xdylanm/modular-system-psu/README.md

# Modular System PSU

A PSU for a modular Eurorack system, featuring +/-12V and 5V rails, USB-C input, and a regulated USB-A output.
