xdylanm/modular-system-psu/docs/assets/images/DCDC_filtering.png

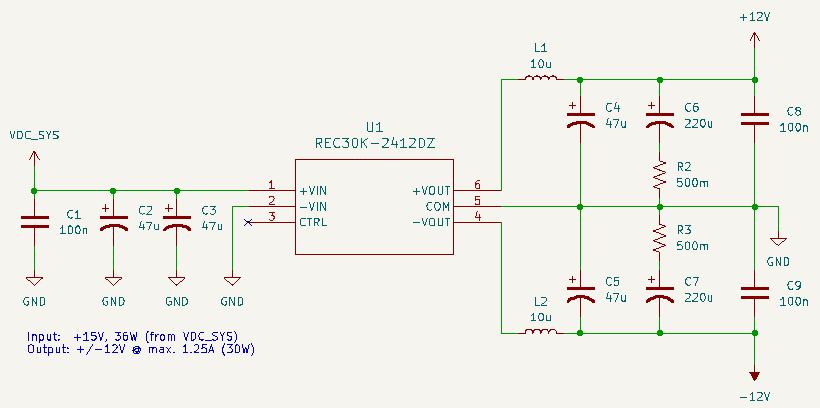
docs/assets/images/DCDC_filtering.png
