xdylanm/modular-system-psu/docs/assets/images/probe_5V_rail.jpg

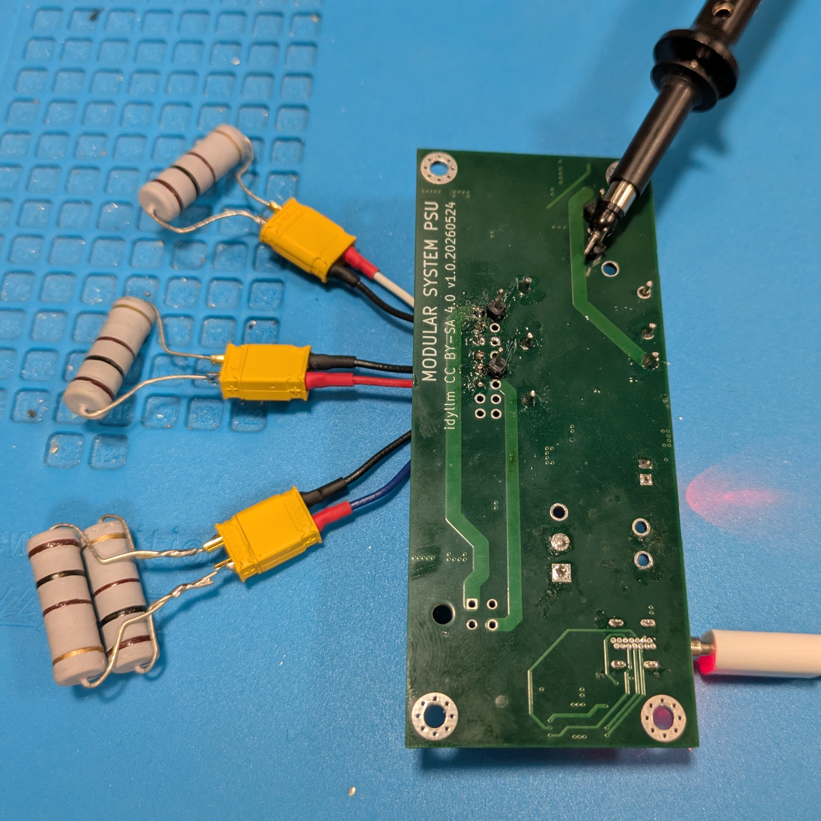
docs/assets/images/probe_5V_rail.jpg
