xdylanm/modular-system-psu/docs/assets/images/probe_recom_output_anno.jpg

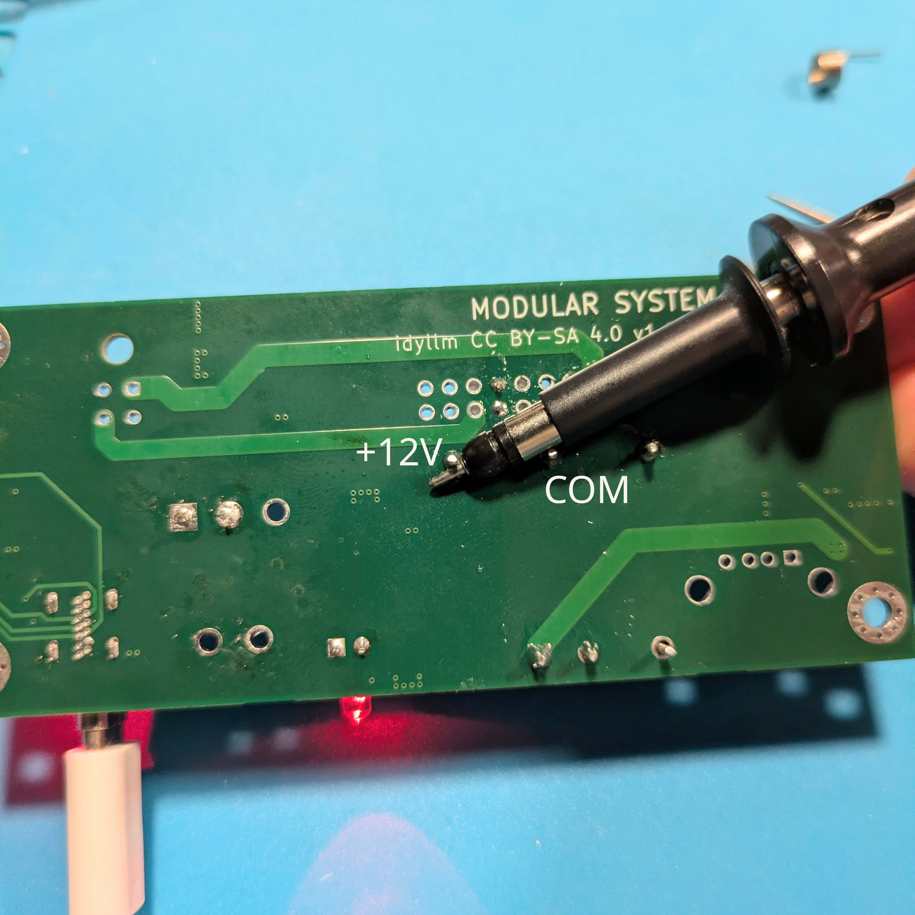
docs/assets/images/probe_recom_output_anno.jpg
