xdylanm/modular-system-psu/docs/assets/schematic.pdf

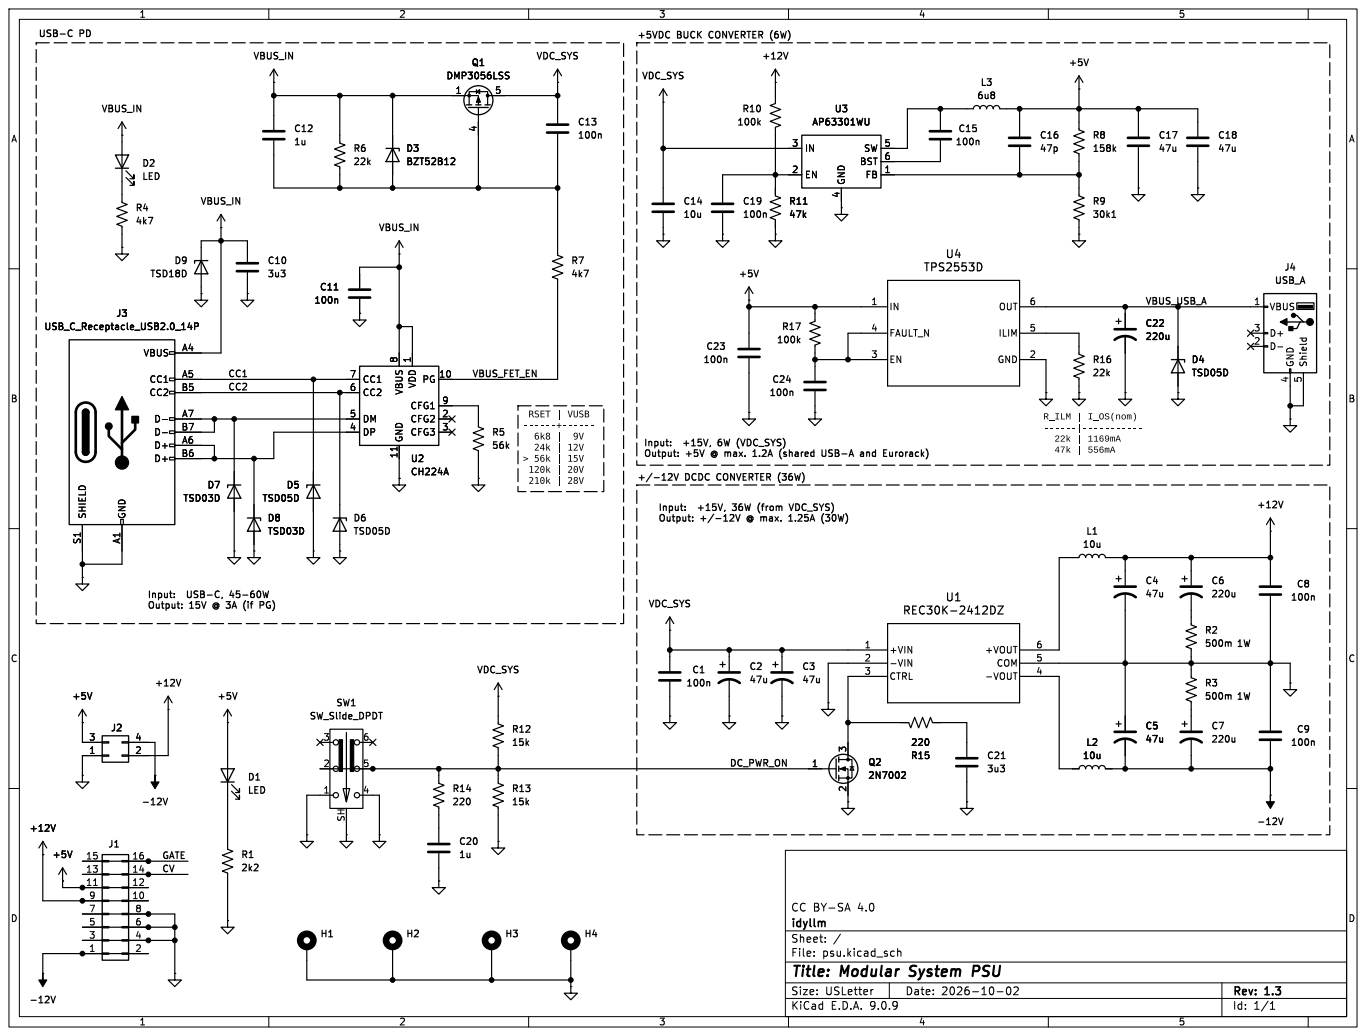
[picture p18: page 1]

1 PG 10 CFG1 9 CFG2 2 CFG3 3 U2 CH224A SHIELD S1 GND A1 VBUS A4 CC1 A5 CC2 B5 D- A7 D- B7 D+ A6 D+ B6

idyllm
File: psu.kicad_sch Sheet: /
Id: 1/1 Title: Modular System PSU
