xdylanm/modular-system-psu/docs/assets/archive/layout/Bottom-Layer-USBC-12V-PSU_2024-03-01.pdf

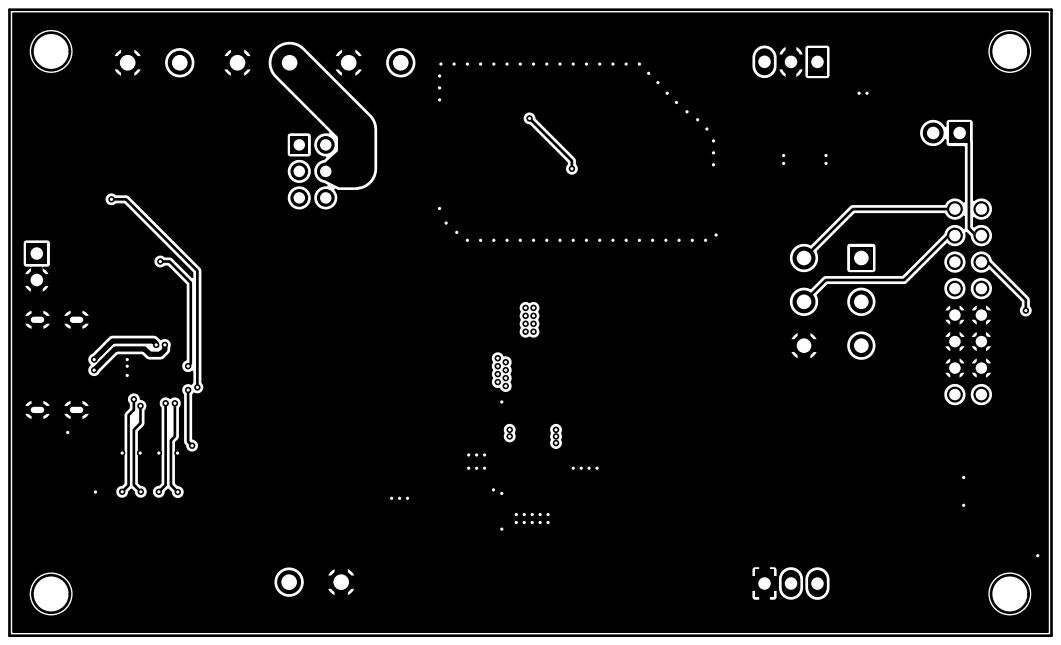
[picture p21: page 1]
