xdylanm/modular-system-psu/docs/assets/archive/layout/Layout-USBC-12V-PSU_2024-03-01.pdf

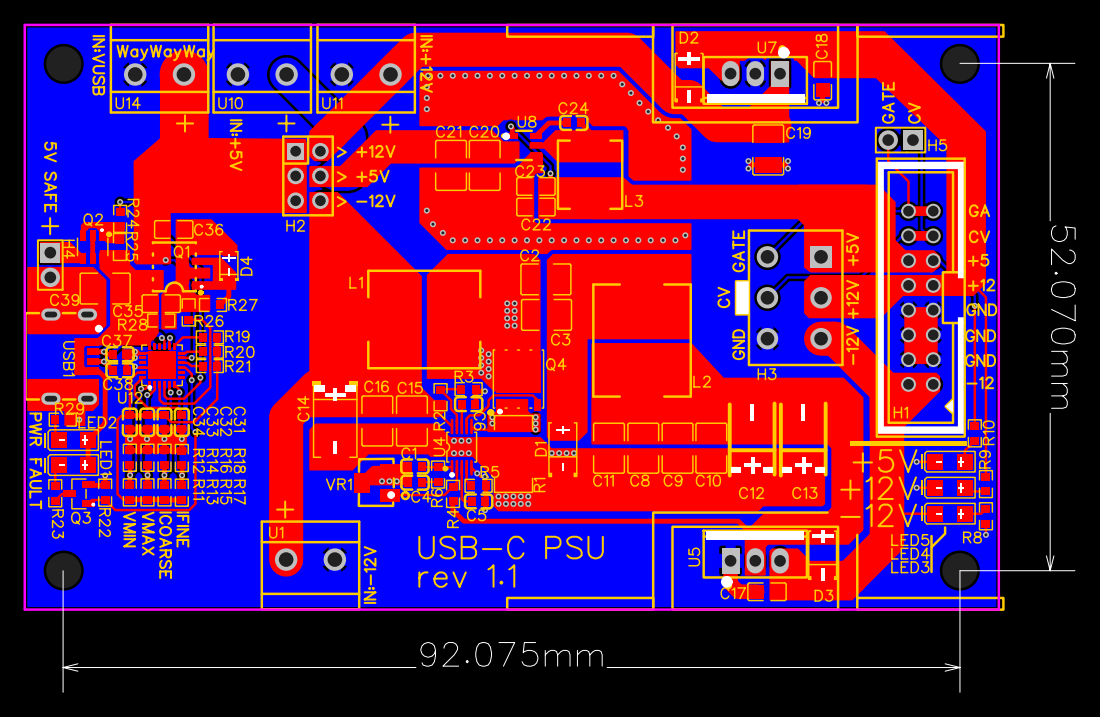
[picture p22: page 1]
