xdylanm/modular-system-psu/docs/assets/archive/layout/Top-Layer-USBC-12V-PSU_2024-03-01.pdf

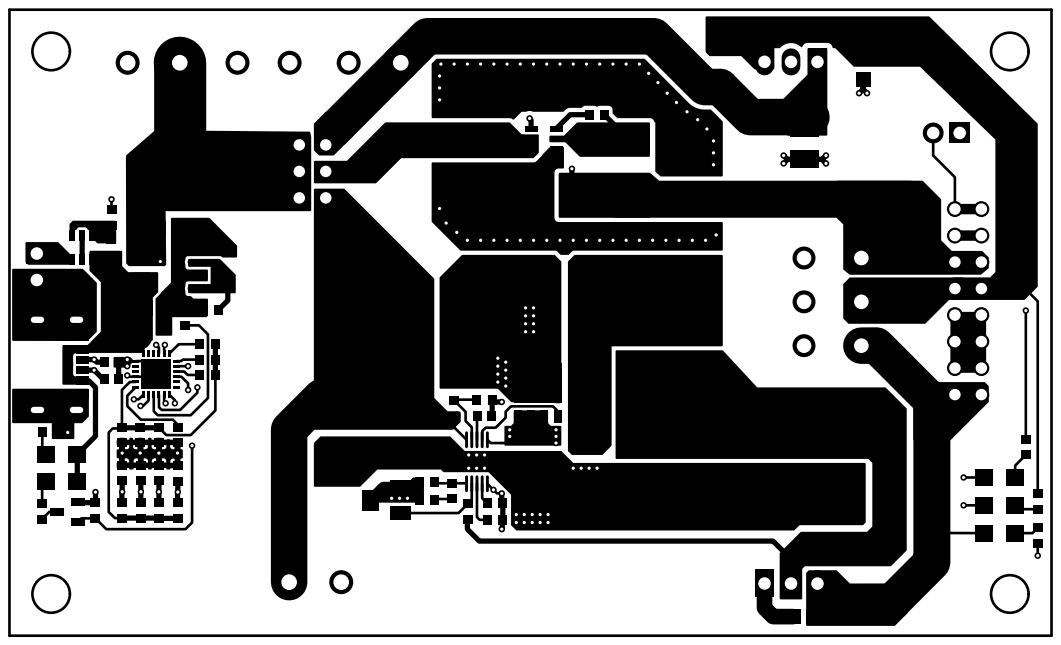
[picture p23: page 1]
