xdylanm/modular-system-psu/docs/assets/archive/layout/Top-Silk-USBC-12V-PSU_2024-03-01.pdf

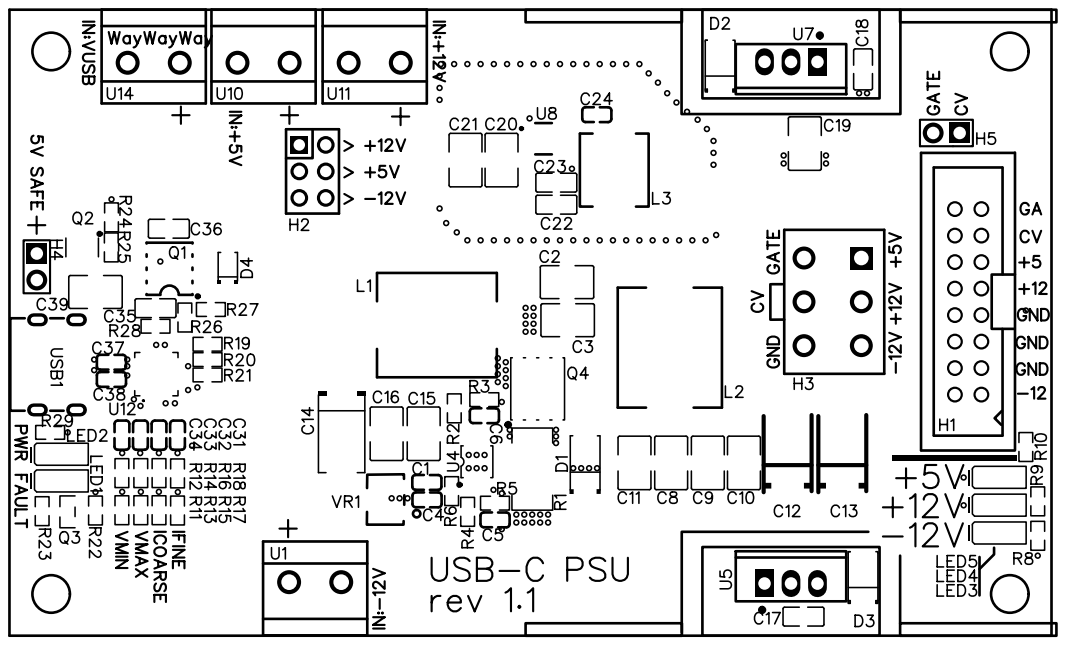
[picture p24: page 1]
