xdylanm/modular-system-psu/hardware/psu/psu.kicad_pcb

## KiCad design hardware/psu/psu.kicad_pcb (2026-10-03)

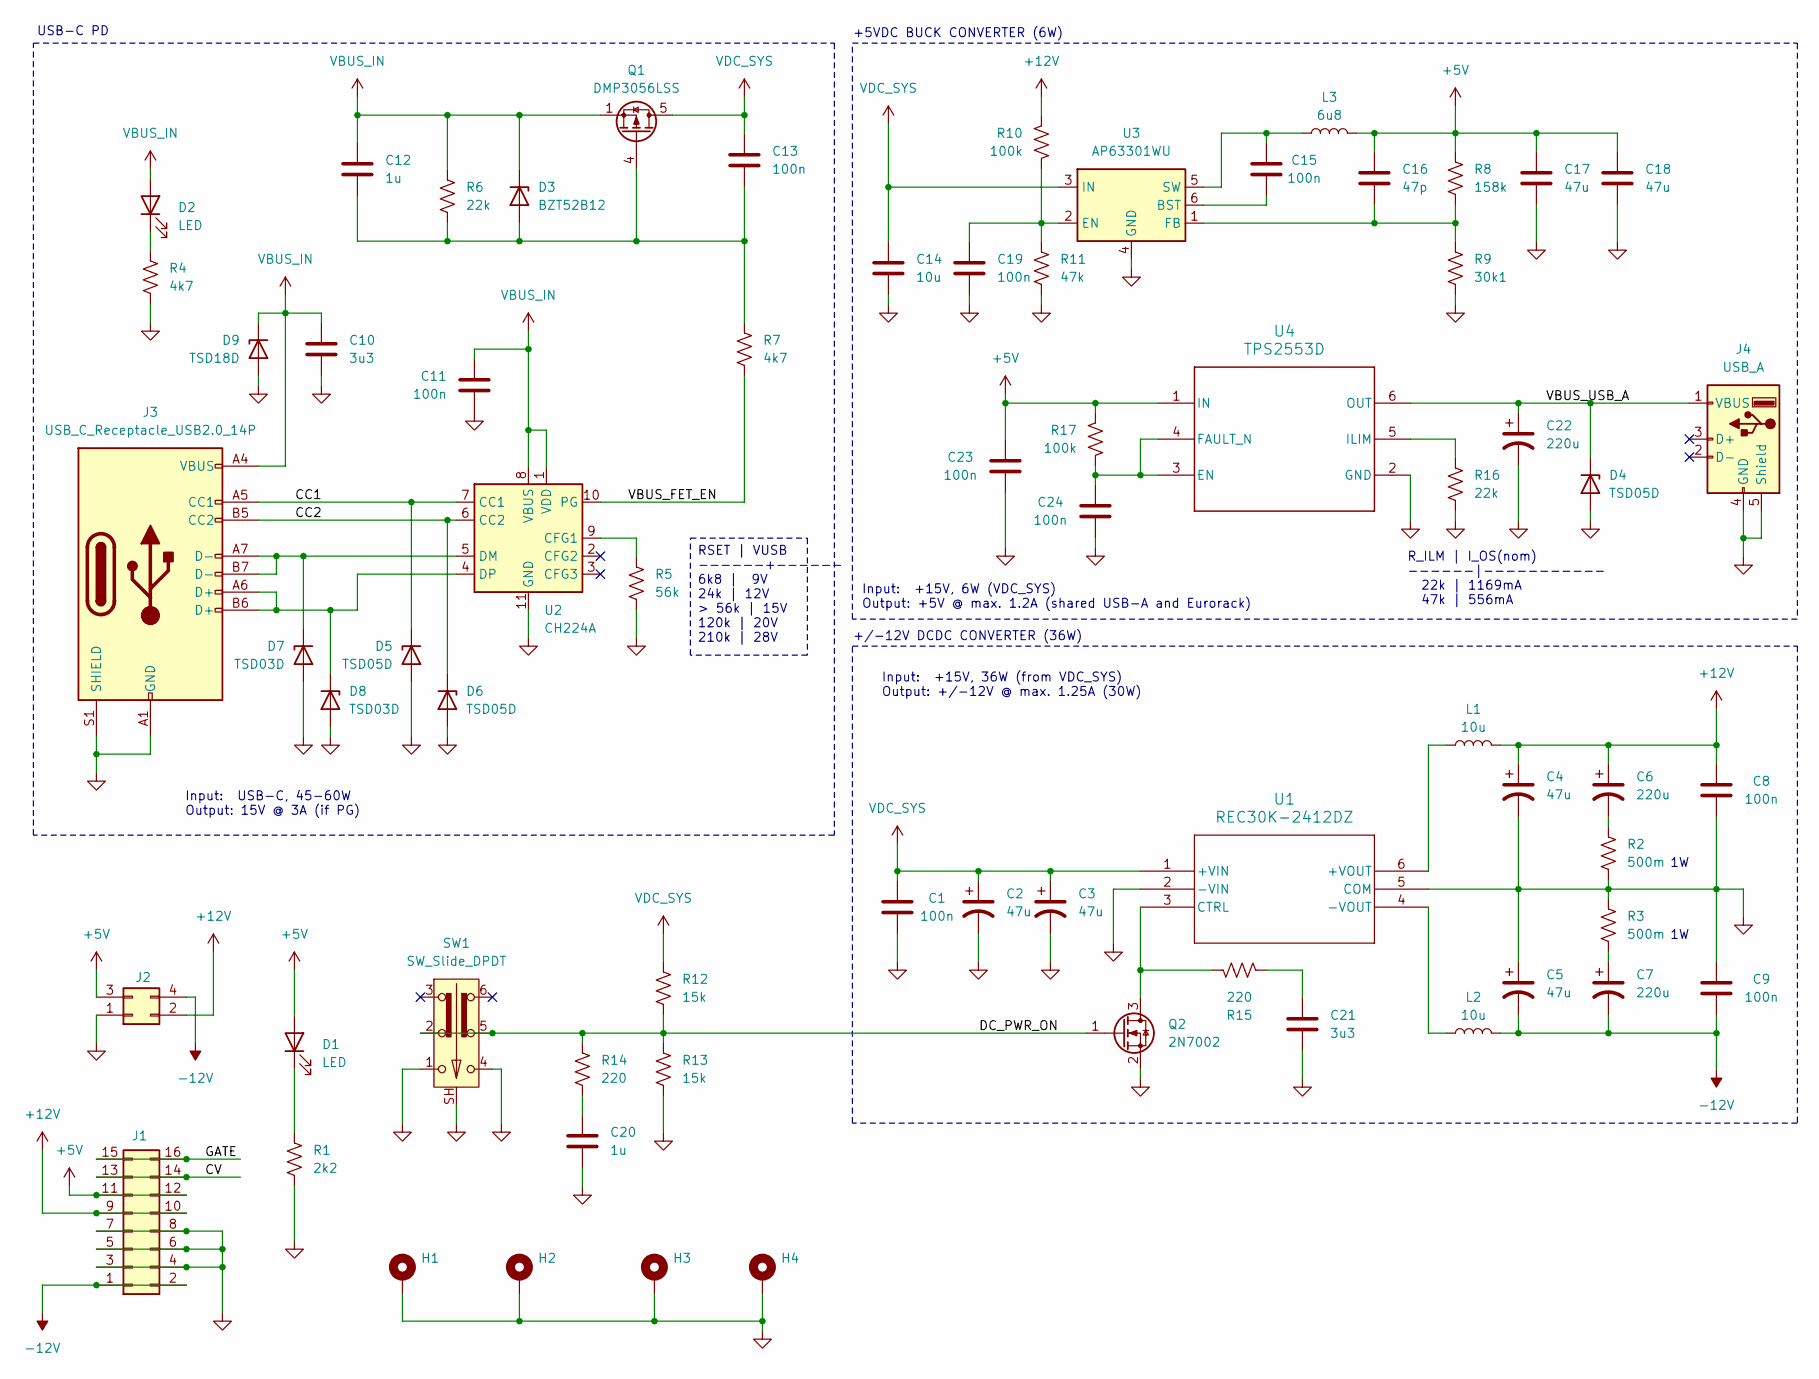
[picture p25: schematic psu.kicad_sch, Modular System PSU]

Parts:
C1, C8, C9, C11, C13, C15, C19, C23, C24: 100n; C_0805_2012Metric_Pad1.18x1.45mm_HandSolder
C2, C3, C4, C5: 47u; CAP_UCD_5X5P8_NCH
C6, C7, C22: 220u; CAP_UCD_6P3X7P7_NCH
C10, C21: 3u3; C_0805_2012Metric_Pad1.18x1.45mm_HandSolder
C12, C20: 1u; C_0805_2012Metric_Pad1.18x1.45mm_HandSolder
C14: 10u; C_1206_3216Metric_Pad1.33x1.80mm_HandSolder
C16: 47p; C_0805_2012Metric_Pad1.18x1.45mm_HandSolder
C17, C18: 47u; C_1206_3216Metric_Pad1.33x1.80mm_HandSolder
D1: LED; LED_D3.0mm
D2: LED; LED_0805_2012Metric_Pad1.15x1.40mm_HandSolder
D3: BZT52B12; D_SOD-123F
D4, D5, D6: TSD05D; D_SOD-323_HandSoldering
D7, D8: TSD03D; D_SOD-323_HandSoldering
D9: TSD18D; D_SOD-323_HandSoldering
H1, H2, H3, H4: MountingHole_Pad; MountingHole_3.2mm_M3_Pad_Via
J1: Conn_02x08_Odd_Even; IDC-Header_2x08_P2.54mm_Horizontal
J2: Conn_02x02_Odd_Even; Molex_Micro-Fit_3.0_43045-0400_2x02_P3.00mm_Horizontal
J3: USB_C_Receptacle_USB2.0_14P; USB_C_Receptacle_Samesky_UJ20-C-R-G-TH-1-P14-TR
J4: USB_A; USB_A_Receptacle_OST_A1HSW6
L1, L2: 10u; IND_BOURNS_SRR6038
L3: 6u8; IND_MGAH06036R8M-10
Q1: DMP3056LSS; SO-8_3.9x4.9mm_P1.27mm
Q2: 2N7002; SOT-23
R1: 2k2; R_0805_2012Metric_Pad1.20x1.40mm_HandSolder
R2, R3: 500m; R_1206_3216Metric_Pad1.30x1.75mm_HandSolder
R4, R7: 4k7; R_0805_2012Metric_Pad1.20x1.40mm_HandSolder
R5: 56k; R_0805_2012Metric_Pad1.20x1.40mm_HandSolder
R6, R16: 22k; R_0805_2012Metric_Pad1.20x1.40mm_HandSolder
R8: 158k; R_0805_2012Metric_Pad1.20x1.40mm_HandSolder
R9: 30k1; R_0805_2012Metric_Pad1.20x1.40mm_HandSolder
R10, R17: 100k; R_0805_2012Metric_Pad1.20x1.40mm_HandSolder
R11: 47k; R_0805_2012Metric_Pad1.20x1.40mm_HandSolder
R12, R13: 15k; R_0805_2012Metric_Pad1.20x1.40mm_HandSolder
R14, R15: 220; R_0805_2012Metric_Pad1.20x1.40mm_HandSolder
SW1: SW_Slide_DPDT; SW_DPDT_LC2255EENP
U1: REC30K-2412DZ; Converter_DCDC_REC30K-2412DZ
U2: CH224A; SSOP-10-1EP_3.9x4.9mm_P1mm_EP2.1x3.3mm
U3: AP63301WU; TSOT-23-6
U4: TPS2553D; SOT-23-6_Handsoldering

Connections:
+5V: C16.1, C17.1, C18.1, C23.2, D1.2 (A), J1.11, J1.12, J2.3, L3.2, R8.1, R17.1, U4.1 (IN)
+12V: C4.1, C6.1, C8.2, J1.9, J1.10, J2.2, L1.2, R10.1
-12V: C5.2, C7.2, C9.1, J1.1, J1.2, J2.4, L2.2
/CC1: D5.1 (K), J3.A5 (CC1), U2.7 (CC1)
/CC2: D6.1 (K), J3.B5 (CC2), U2.6 (CC2)
/CV: J1.13, J1.14
/DC_PWR_ON: Q2.1 (G), R12.2, R13.1, R14.1, SW1.2 (B), SW1.5 (B)
/GATE: J1.15, J1.16
/VBUS_FET_EN: R7.2, U2.10 (PG)
/VBUS_USB_A: C22.1, D4.1 (K), J4.1 (VBUS), U4.6 (OUT)
GND: C1.1, C2.2, C3.2, C4.2, C5.1, C8.1, C9.2, C10.2, C11.2, C14.2, C17.2, C18.2, C19.1, C20.1, C21.1, C22.2, C23.1, C24.1, D4.2 (A), D5.2 (A), D6.2 (A), D7.2 (A), D8.2 (A), D9.2 (A), H1.1, H2.1, H3.1, H4.1, J1.3, J1.4, J1.5, J1.6, J1.7, J1.8, J2.1, J3.A1 (GND), J3.A12 (GND), J3.B1 (GND), J3.B12 (GND), J3.S1 (SHIELD), J4.4 (GND), J4.5 (Shield), Q2.2 (S), R1.2, R2.2, R3.1, R4.2, R5.2, R9.2, R11.2, R13.2, R16.2, SW1.1 (A), SW1.4 (A), SW1.SH (A), U1.2 (-VIN), U1.5 (COM), U2.11 (GND), U3.4 (GND), U4.2 (GND)
unnamed: C6.2, R2.1
unnamed: C7.1, R3.2
unnamed: C20.2, R14.2
unnamed: C21.2, R15.2
unnamed: D1.1 (K), R1.1
unnamed: D2.1 (K), R4.1
unnamed: C12.2, C13.2, D3.2 (A), Q1.4 (G), R6.2, R7.1
unnamed: D7.1 (K), J3.A7 (D-), J3.B7 (D-), U2.5 (DM)
unnamed: D8.1 (K), J3.A6 (D+), J3.B6 (D+), U2.4 (DP)
unnamed: Q2.3 (D), R15.1, U1.3 (CTRL)
unnamed: L1.1, U1.6 (+VOUT)
unnamed: L2.1, U1.4 (-VOUT)
unnamed: R5.1, U2.9 (CFG1)
unnamed: C15.1, U3.6 (BST)
unnamed: C19.2, R10.2, R11.1, U3.2 (EN)
unnamed: C16.2, R8.2, R9.1, U3.1 (FB)
unnamed: C15.2, L3.1, U3.5 (SW)
unnamed: C24.2, R17.2, U4.3 (EN), U4.4 (FAULT_N)
unnamed: R16.1, U4.5 (ILIM)
VBUS_IN: C10.1, C11.1, C12.1, D2.2 (A), D3.1 (K), D9.1 (K), J3.A4 (VBUS), J3.A9 (VBUS), J3.B4 (VBUS), J3.B9 (VBUS), Q1.1 (S), Q1.2 (S), Q1.3 (S), R6.1, U2.1 (VDD), U2.8 (VBUS)
VDC_SYS: C1.2, C2.1, C3.1, C13.1, C14.1, Q1.5 (D), Q1.6 (D), Q1.7 (D), Q1.8 (D), R12.1, U1.1 (+VIN), U3.3 (IN)

Notes on the sheet:
Input: +15V, 36W (from VDC_SYS) Output: +/-12V @ max. 1.25A (30W)
Input: +15V, 6W (VDC_SYS) Output: +5V @ max. 1.2A (shared USB-A and Eurorack)
Input: USB-C, 45-60W Output: 15V @ 3A (if PG)
+5VDC BUCK CONVERTER (6W)
USB-C PD
R_ILM | I_OS(nom) ------|----------- 22k | 1169mA 47k | 556mA
+/-12V DCDC CONVERTER (36W)
RSET | VUSB ------+------ 6k8 | 9V 24k | 12V > 56k | 15V 120k | 20V 210k | 28V

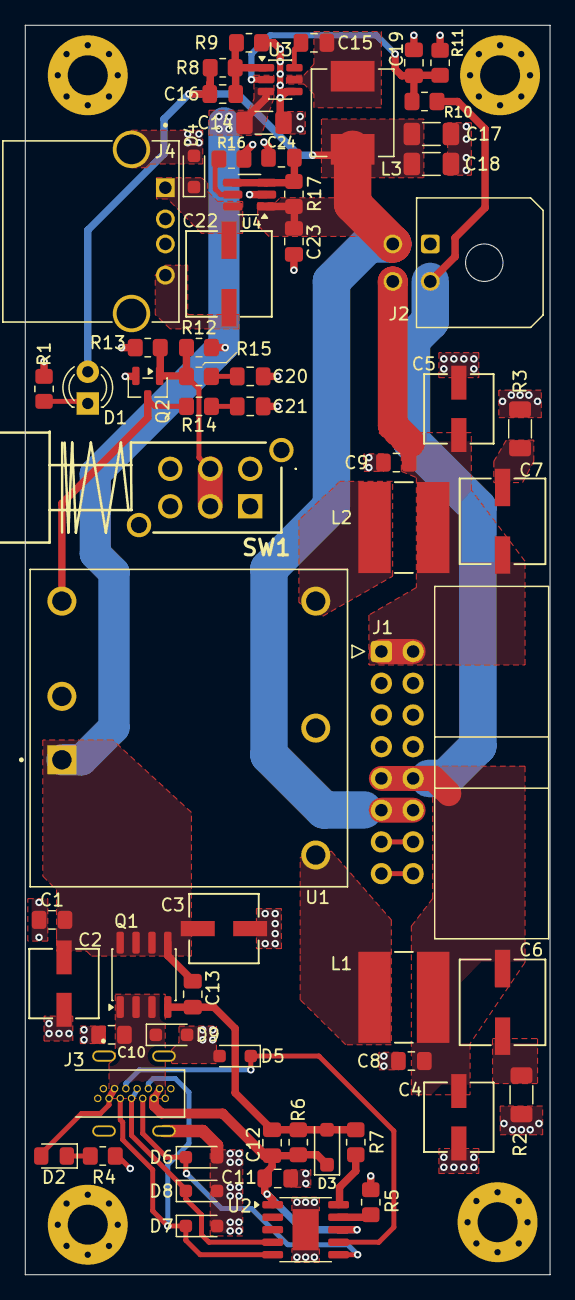
[picture p26: board psu.kicad_pcb from above]

Board: 4 copper layers, 42.0 x 100.0 mm, 68 parts (0 on the bottom side), 32 nets.
