xdylanm/modular-system-psu/(commit log)

2026-05-25 First board version, design docs and decisions, updated docs with archival version of old design
    [psu.kicad_pcb, psu.kicad_sch]
2026-05-25 Missed BOM files
    [BOM_USBC-12V-PSU_2024-03-01.csv, bom.csv]
2026-05-25 Doc updates: rendering math in notebooks, fixing image paths in notebooks, minor schematic tidyup (no changes to nets)
    [psu.kicad_sch]
2026-06-27 Version 1.1 board. Measurements complete, updated power on switch design, refined in-rush limiting
    [bom.csv, psu.kicad_pcb, psu.kicad_sch]
2026-07-25 Fixed ref for SW1, updated BOM for v1.1
    [bom.csv, psu.kicad_sch]
2026-10-01 Faceplate for v1.1
    [psu-faceplate.kicad_pcb, psu-faceplate.kicad_sch]
2026-10-01 Fix power on behavior with delay C to ground on REC30K CTRL, tick board rev to 1.2
    [psu.kicad_pcb, psu.kicad_sch]
2026-10-01 Updating docs for rev 1.2
    [bom.csv]
2026-10-03 Rev 1.3 board with ESD protection and current protection for the USB A output (not fabricated yet)
    [bom.csv, psu.kicad_pcb, psu.kicad_sch]
