xdylanm/modular-system-psu/(notices)

Notices in the files:
hardware/psu-faceplate/psu-faceplate.kicad_pcb:
CC BY-SA 4.0
hardware/psu/psu.kicad_pcb:
idyllm CC BY-SA 4.0 v1.3.20261002
